RLU-fpga/FPGA_OPTI_DLL_SYNC/Elektronika/Moduliniu ploksciu priekis.png

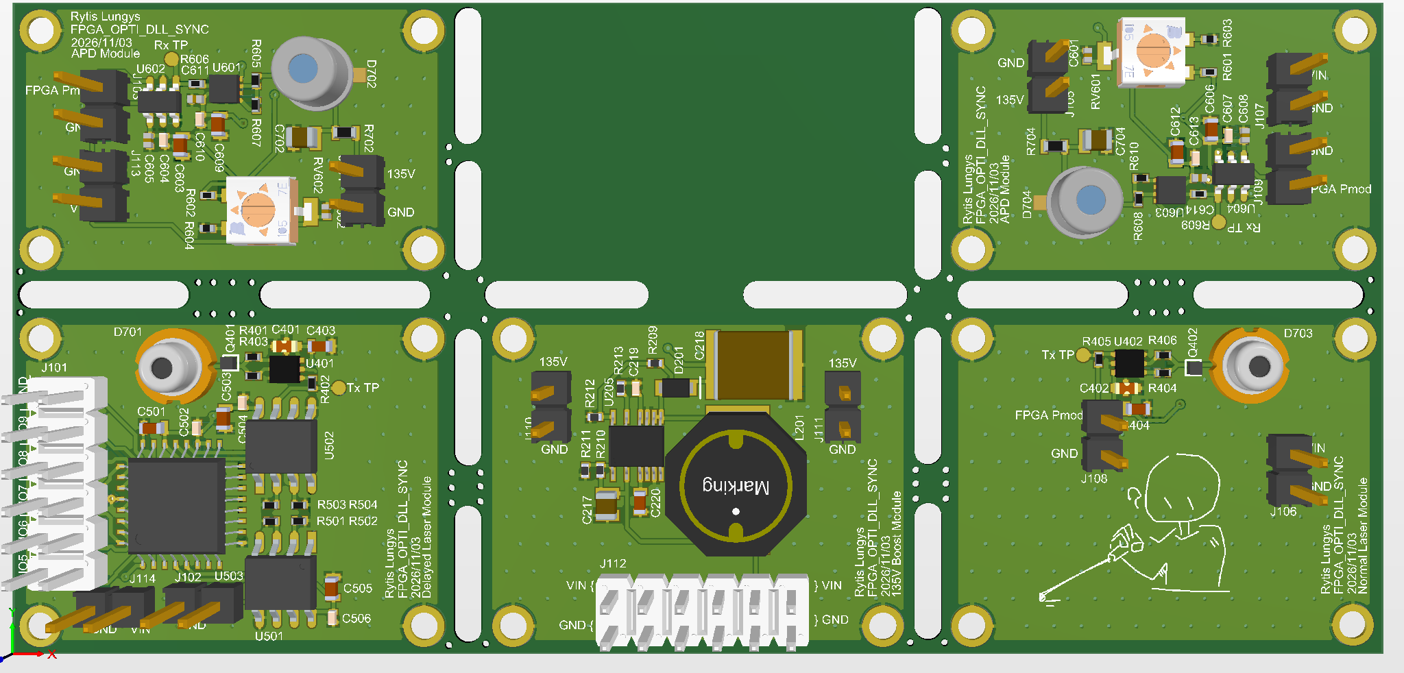
Elektronika/Moduliniu ploksciu priekis.png
