RLU-fpga/FPGA_OPTI_DLL_SYNC/Elektronika/Moduliniu plokscius galas.png

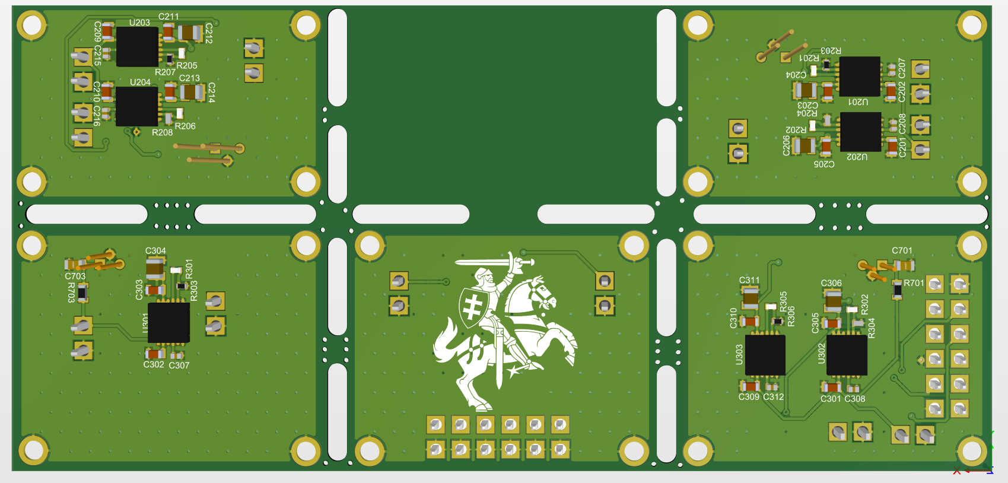
Elektronika/Moduliniu plokscius galas.png
