RLU-fpga/FPGA_OPTI_DLL_SYNC/Mechanika/Kinematinis_Veidriodzio_Laikiklis.png

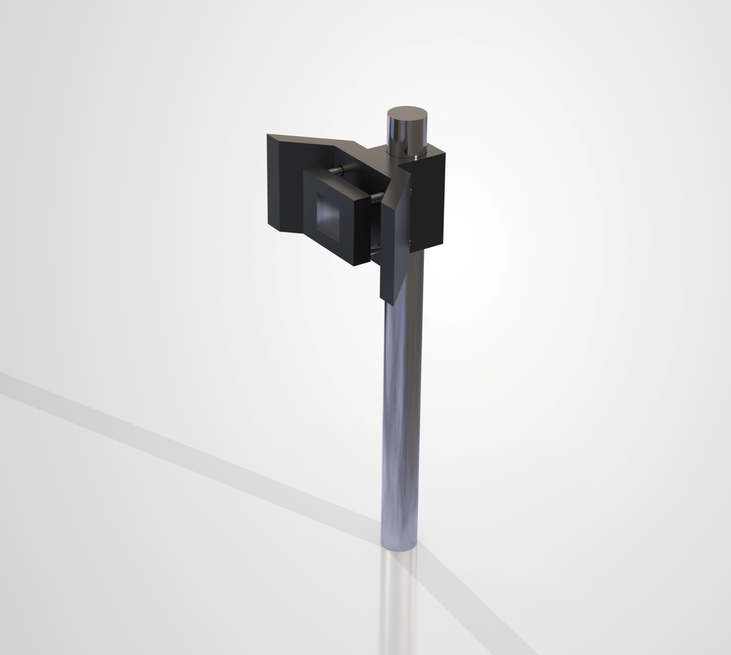
Mechanika/Kinematinis_Veidriodzio_Laikiklis.png
