RLU-fpga/FPGA_OPTI_DLL_SYNC/Vizija.png

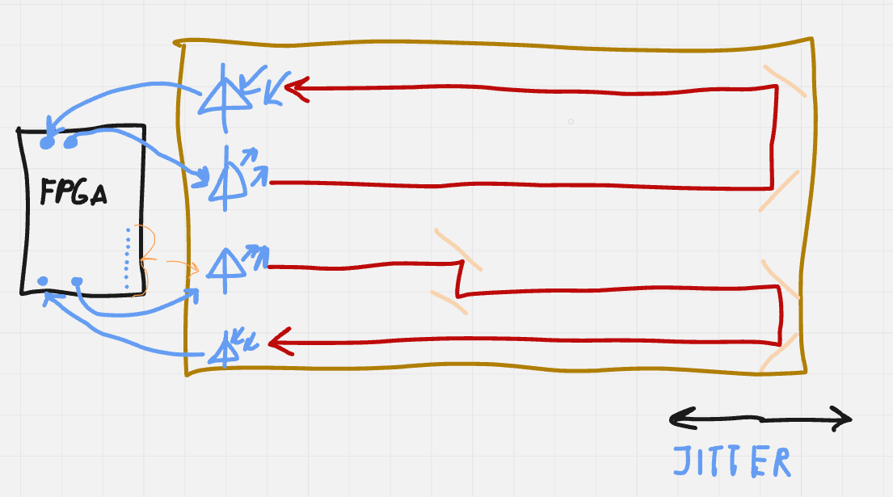
Vizija.png
