RLU-fpga/FPGA_OPTI_DLL_SYNC/BOM.xlsx

Nr. | Komponento kodas | Komponento pavadinimas | Kiekis | Vnt. Kaina | Visu komp. kaina | Designator | Link
1 | CGA3E1X7R1E105K080AC | 1uF | 24 | 0.15 | 3.6 | C201, C202, C203, C205, C209, C210, C211, C213, C220, C301, C302, C303, C305, C309, C310, C401, C403, C405, C503, C504, C603, C606, C609, C612 | https://www.mouser.lt/en/ProductDetail/TDK/CGA3E1X7R1E105K080AC?qs=NRhsANhppD9VxGl2AsmRpw%3D%3D
2 | GRJ21BR61E106KE01K | 10uF | 8 | 0.24 | 1.92 | C204, C206, C212, C214, C217, C304, C306, C311 | https://www.mouser.lt/en/ProductDetail/Murata-Electronics/GRJ21BR61E106KE01K?qs=5aG0NVq1C4w0N7mxlKMI2A%3D%3D
3 | C0402C103J5RACTU | 10nF | 13 | 0.12 | 1.56 | C207, C208, C215, C216, C307, C308, C312, C601, C602, C605, C608, C611, C614 | https://www.mouser.lt/en/ProductDetail/KEMET/C0402C103J5RACTU?qs=DBJr%252BvBUjU4XbiW96tiGZw%3D%3D
4 | CGA9N3X7R2E105M230KA | 1uF | 1 | 1.14 | 1.14 | C218 | https://www.mouser.lt/en/ProductDetail/TDK/CGA9N3X7R2E105M230KA?qs=xLDY6iXSiQZ8rhqg1Ec9Fg%3D%3D
5 | C1005X7R1E104K050BB | 100nF | 8 | 0.17 | 1.36 | C219, C402, C404, C406, C604, C607, C610, C613 | https://www.mouser.lt/en/ProductDetail/TDK/C1005X7R1E104K050BB?qs=dfay7wIA1uG4zQgf5CEiiA%3D%3D
6 | NFM18PC104R1C3D | 100n FT | 2 | 0.21 | 0.42 | C501, C502 | https://www.mouser.lt/en/ProductDetail/Murata-Electronics/NFM18PC104R1C3D?qs=G44QFJllJuCN26lF8UAu9Q%3D%3D
7 | C0603C680J5RACTU | 68pF | 2 | 0.41 | 0.82 | C701, C703 | https://www.mouser.lt/en/ProductDetail/KEMET/C0603C680J5RACTU?qs=gt1LBUVyoHkeg7uPJfU%2Fxw%3D%3D
8 | GCM21AR72E102KWB1J | 1nF | 2 | 0.51 | 1.02 | C702, C704 | https://www.mouser.lt/en/ProductDetail/Murata-Electronics/GCM21AR72E102KWB1J?qs=6avfeC6zeS7nEc4eaMrKgA%3D%3D
9 | RB558VAM150TR | SDiode | 1 | 0.34 | 0.34 | D201 | https://www.mouser.lt/en/ProductDetail/ROHM-Semiconductor/RB558VAM150TR?qs=4v%252BiZTmLVHHlYdkq3pl7bg%3D%3D
10 | PLT5 450GB | 450nm 100mW lazeris | 2 | 26.45 | 52.9 | D701, D703 | https://www.mouser.lt/en/ProductDetail/ams-OSRAM/PLT5-450GB?qs=rQFj71Wb1eV9IX8cpcqYXg%3D%3D
11 | MTAPD-06-007 | Avalanchinis photo diodas | 2 | 43.72 | 87.44 | D702, D704 | https://www.mouser.lt/en/ProductDetail/Marktech-Optoelectronics/MTAPD-06-007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
12 | TSW-106-09-F-D | Spikelinis conectorius | 2 | 0.97 | 1.94 | J101, J103 | https://www.mouser.lt/en/ProductDetail/Samtec/TSW-106-09-F-D?qs=Cqqh%252BS766wkaRvkfCPh4JQ%3D%3D
13 | TSW-102-16-F-S-RA | Spikelinis conectorius | 12 | 0.24 | 2.88 | J102, J104, J105, J106, J107, J108, J109, J110, J111, J112, J113, J114 | https://www.mouser.lt/en/ProductDetail/Samtec/TSW-102-16-F-S-RA?qs=rU5fayqh%252BE030xBuy%2F1xJg%3D%3D
14 | 744066101 | 100uH | 1 | 1.78 | 1.78 | L201 | https://www.mouser.lt/en/ProductDetail/Wurth-Elektronik/744066101?qs=PGXP4M47uW5S%252BY2N7KhrTQ%3D%3D
15 | EPC2036 | GaN FET | 2 | 1.81 | 3.62 | Q501, Q502 | https://www.mouser.lt/en/ProductDetail/EPC/EPC2036?qs=u4fy%2FsgLU9PCoc5QZ%2FhbEg%3D%3D
16 | CR0402-FX-4752GLF | 47K5 | 4 | 0.09 | 0.36 | R201, R205, R301, R305 | https://www.mouser.lt/en/ProductDetail/Bourns/CR0402-FX-4752GLF?qs=ePR1ZvdkOKLsJKyS4c0SOQ%3D%3D
17 | CR0402-FX-2322GLF | 23K2 | 3 | 0.09 | 0.27 | R202, R206, R302 | https://www.mouser.lt/en/ProductDetail/Bourns/CR0402-FX-2322GLF?qs=JflQ4L8so%2FsQg%252B6Y1yp1SA%3D%3D
18 | CRCW040215K0FKED | 15k | 4 | 0.22 | 0.88 | R203, R207, R303, R306 | https://www.mouser.lt/en/ProductDetail/Vishay/CRCW040215K0FKED?qs=QPqDnsKvzKcgNzJF1YM3gA%3D%3D
19 | CRCW040213K3FKED | 13K3 | 3 | 0.13 | 0.39 | R204, R208, R304 | https://www.mouser.lt/en/ProductDetail/Vishay/CRCW040213K3FKED?qs=8wskyPz2qw2Dyv3qbAQfDw%3D%3D
20 | RC0402FR-7D1ML | 1M | 2 | 0.09 | 0.18 | R209, R210 | https://www.mouser.lt/en/ProductDetail/YAGEO/RC0402FR-7D1ML?qs=F5EMLAvA7IBbmOaJlvZVMQ%3D%3D
21 | RC0402FR-07287KL | 287k | 1 | 0.09 | 0.09 | R211 | https://www.mouser.lt/en/ProductDetail/YAGEO/RC0402FR-07287KL?qs=UOUeRUa%252B8WmeTeP982UyHg%3D%3D
22 | RC0402FR-0712K1L | 12k1 | 1 | 0.09 | 0.09 | R212 | https://www.mouser.lt/en/ProductDetail/YAGEO/RC0402FR-0712K1L?qs=sxZXDnvRBEjWHOPbh48R0Q%3D%3D
23 | RE0402BRE07154KL | 154k | 1 | 0.19 | 0.19 | R213 | https://www.mouser.lt/en/ProductDetail/YAGEO/RE0402BRE07154KL?qs=TyBUSTk9pD9kpfVWq%252BbFjA%3D%3D
24 | ERA-2AED201X | 200R | 6 | 0.09 | 0.54 | R401, R402, R403, R404, R607, R610 | https://www.mouser.lt/en/ProductDetail/Panasonic-Industry/ERA-2AED201X?qs=nho8PGNfA6pknZRuzWVIwQ%3D%3D
25 | CRT0402-FZ-2R00GLF | 2R2 | 2 | 0.09 | 0.18 | R501, R505 | https://www.mouser.lt/en/ProductDetail/Bourns/CRT0402-FZ-2R00GLF?qs=v6mhsJQa3reFEgOwp9Hjlg%3D%3D
26 | ERA-2AKD220X | 22R | 2 | 0.09 | 0.18 | R502, R506 | https://www.mouser.lt/en/ProductDetail/Panasonic-Industry/ERA-2AKD220X?qs=nho8PGNfA6rnpt2x0U9KVw%3D%3D
27 | CRCW040247R0FKED | 47R | 2 | 0.14 | 0.28 | R503, R507 | https://www.mouser.lt/en/ProductDetail/Vishay/CRCW040247R0FKED?qs=rzhQWu8UUS1jEbQS506e8Q%3D%3D
28 | CRT0402-FZ-1R00GLF | 1R | 2 | 0.14 | 0.28 | R504, R508 | https://www.mouser.lt/en/ProductDetail/Vishay/CRCW040247R0FKED?qs=rzhQWu8UUS1jEbQS506e8Q%3D%3D
29 | ERA-2VEB1000X | 100R | 4 | 0.25 | 1 | R601, R602, R606, R609 | https://www.mouser.lt/en/ProductDetail/Panasonic-Industry/ERA-2VEB1000X?qs=OlC7AqGiEDnVwVem9FjbZg%3D%3D
30 | ERJ-U02F3301X | 3K3 | 2 | 0.11 | 0.22 | R603, R604 | https://www.mouser.lt/en/ProductDetail/Panasonic-Industry/ERJ-U02F3301X?qs=bKFmlxG1yYAqEK%252Bo9PdYEQ%3D%3D
31 | CRT0402-DZ-10R0GLF | 10R | 2 | 0.11 | 0.22 | R605, R608 | https://www.mouser.lt/en/ProductDetail/Bourns/CRT0402-DZ-10R0GLF?qs=1mbolxNpo8ePU9UbXC2foA%3D%3D
32 | ERA-3AEB102V | 1K | 2 | 0.28 | 0.56 | R701, R703 | https://www.mouser.lt/en/ProductDetail/Panasonic-Industry/ERA-3AEB102V?qs=1VWA5LkbEaoqrqE7i0E0xA%3D%3D
33 | CR0603-FX-1003ELF | 100k | 2 | 0.09 | 0.18 | R702, R704 | https://www.mouser.lt/en/ProductDetail/Bourns/CR0603-FX-1003ELF?qs=K5ddiUFZPT49r0RoKWcKqg%3D%3D
34 | 3314G-1-502E | 5K TRIM | 2 | 1.35 | 2.7 | RV601, RV602 | https://www.mouser.lt/en/ProductDetail/Bourns/3314G-1-502E?qs=VLB%252BJtKnxCKiclk60ejpgA%3D%3D
35 | LP38798SD-ADJ/NOPB | LDO | 7 | 4.46 | 31.22 | U201, U202, U203, U204, U301, U302, U303 | https://www.mouser.lt/en/ProductDetail/Texas-Instruments/LP38798SD-ADJ-NOPB?qs=n38Wlrh4b4YOH8S0VaMj1g%3D%3D
36 | LT8331EMSE#PBF | Boost keitiklis | 1 | 9.08 | 9.08 | U205 | https://www.mouser.lt/en/ProductDetail/Analog-Devices/LT8331EMSEPBF?qs=oahfZPh6IAIKOCqw%2F9bOKA%3D%3D
37 | MC100EPT20DR2G | LVCMOS vertejas | 1 | 6.56 | 6.56 | U401 | https://www.mouser.lt/en/ProductDetail/onsemi/MC100EPT20DR2G?qs=zorda86t5M%252BrhsQdqEkc9w%3D%3D
38 | MC100EPT21DR2G | LVCMOS vertejas | 1 | 6.23 | 6.23 | U402 | https://www.mouser.lt/en/ProductDetail/onsemi/MC100EPT21DR2G?qs=zorda86t5M%2FXPFeU0zEWZg%3D%3D
39 | MC100EP195FAG | Velintojas | 1 | 17.78 | 17.78 | U403 | https://www.mouser.lt/en/ProductDetail/onsemi/MC100EP195FAG?qs=zorda86t5M%2FizCrh52Y4cQ%3D%3D
40 | LMG1025QDEERQ1 | GaN Driver | 2 | 11.4 | 22.8 | U501, U502 | https://www.mouser.lt/en/ProductDetail/Texas-Instruments/LMG1025QDEERQ1?qs=B6kkDfuK7%2FDnZFw0EtktSw%3D%3D
41 | OPA855IDSGT | Op Ampas | 2 | 7.94 | 15.88 | U601, U603 | https://www.mouser.lt/en/ProductDetail/Texas-Instruments/OPA855IDSGT?qs=w%2Fv1CP2dgqr2Ni5Q69cmdQ%3D%3D
42 | TLV3501AIDBVT | Komporatorius | 2 | 4.26 | 8.52 | U602, U604 | https://www.mouser.lt/en/ProductDetail/Texas-Instruments/TLV3501AIDBVT?qs=m96fseALk3Uwvp8U7e8R1g%3D%3D
 |  |  |  | Viso Kaina: | 289.6
