RLU-fpga/FPGA_OPTI_DLL_SYNC/Mechanika/Veidrodzio_laikiklis/Laikiklio_laikiklis.SLDPRT

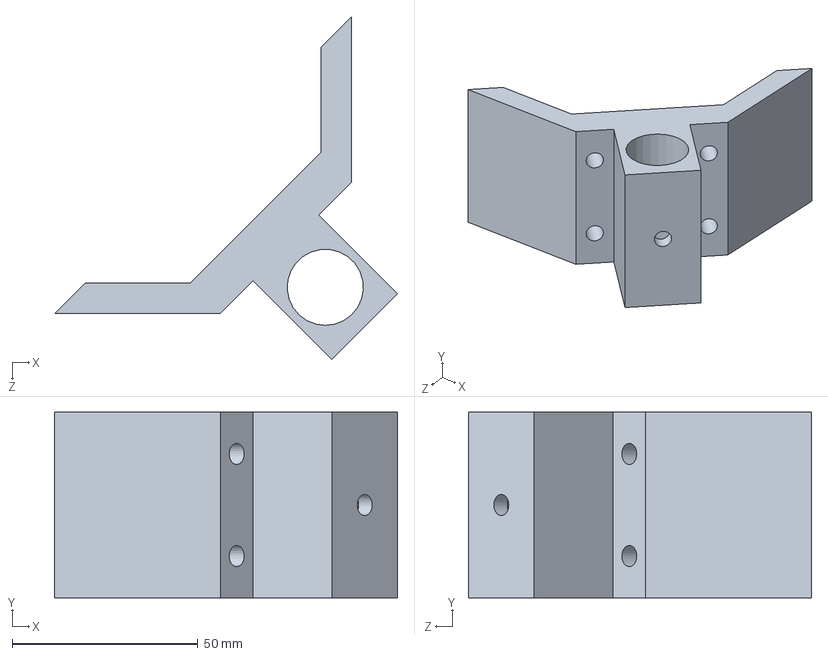
[picture p5: CAD file, 2026-11-05]
Mechanika/Veidrodzio_laikiklis/Laikiklio_laikiklis.SLDPRT
92.4 x 50.0 x 92.4 mm
