RLU-fpga/FPGA_OPTI_DLL_SYNC/Mechanika/Veidrodzio_laikiklis/Strypas_laikiklis.SLDPRT

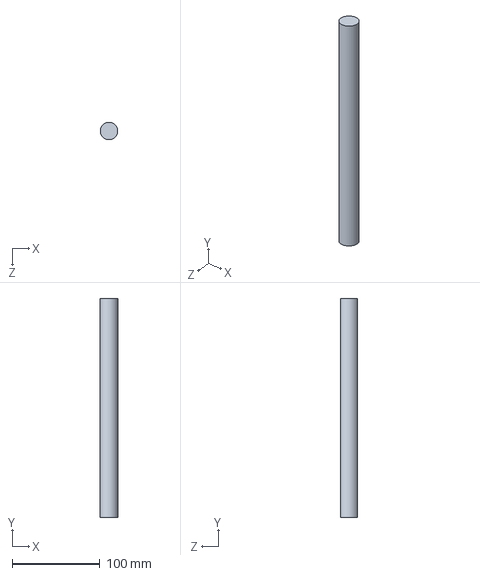
[picture p6: CAD file, 2026-11-05]
Mechanika/Veidrodzio_laikiklis/Strypas_laikiklis.SLDPRT
20.0 x 250.0 x 20.0 mm
