RLU-fpga/FPGA_OPTI_DLL_SYNC/Mechanika/Veidrodzio_laikiklis/Veidrodzio_laikiklis.SLDPRT

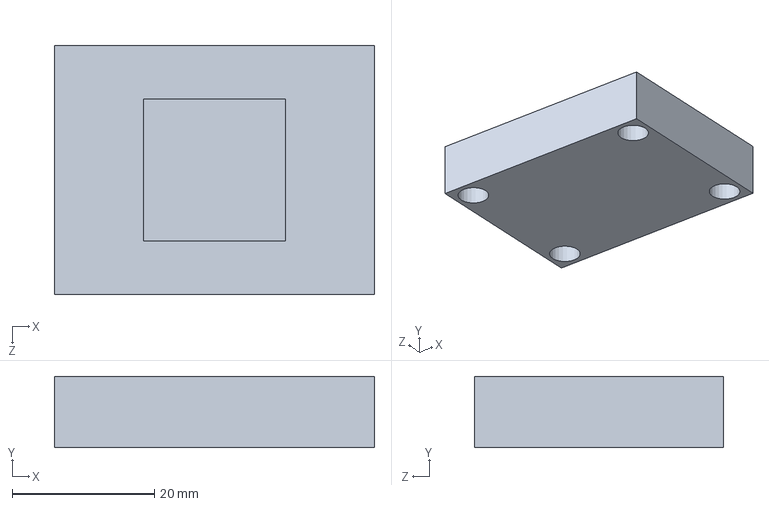
[picture p7: CAD file, 2026-11-05]
Mechanika/Veidrodzio_laikiklis/Veidrodzio_laikiklis.SLDPRT
45.0 x 10.0 x 35.0 mm
