RLU-fpga/FPGA_OPTI_DLL_SYNC/Mechanika/Veidrodzio_laikiklis/Veidrodis_laikiklis.SLDPRT

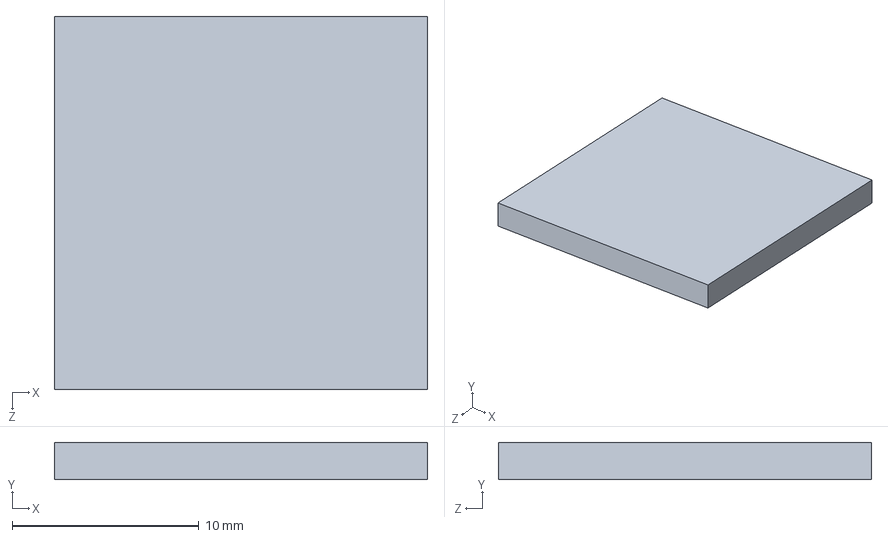
[picture p8: CAD file, 2026-11-05]
Mechanika/Veidrodzio_laikiklis/Veidrodis_laikiklis.SLDPRT
20.0 x 2.00 x 20.0 mm
