RLU-fpga/FPGA_OPTI_DLL_SYNC/Mechanika/Veidrodzio_laikiklis/Kinematinis_Veidriodzio_Laikiklis.SLDASM

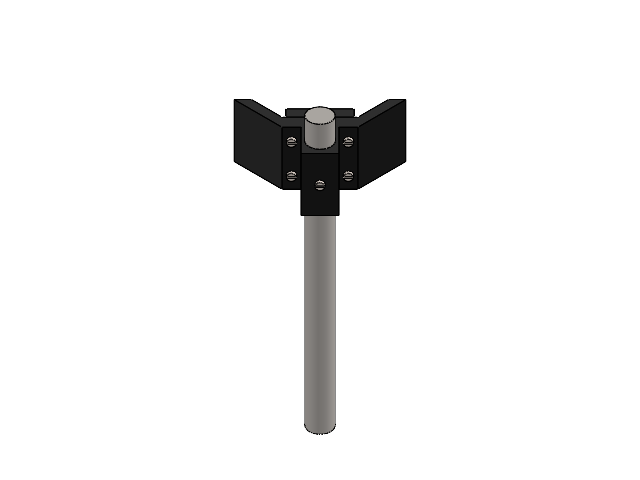
[picture p9: CAD file, 2026-11-05]
Mechanika/Veidrodzio_laikiklis/Kinematinis_Veidriodzio_Laikiklis.SLDASM
Laikiklio_laikiklis
Veidrodzio_laikiklis
Strypas_laikiklis
Veidrodis_laikiklis
slotted cheese head screw_din x 5
