RLU-fpga/FPGA_OPTI_DLL_SYNC/(list of files, cad)

Other CAD files:
Mechanika/Veidrodzio_laikiklis/Kinematinis_Veidriodzio_Laikiklis.SLDDRW
Mechanika/Veidrodzio_laikiklis/Laikiklio_laikiklis.SLDDRW
Mechanika/Veidrodzio_laikiklis/Strypas_laikiklis.SLDDRW
Mechanika/Veidrodzio_laikiklis/Veidrodis_laikiklis.SLDDRW
Mechanika/Veidrodzio_laikiklis/Veidrodzio_laikiklis.SLDDRW
