RLU-fpga/FPGA_OPTI_DLL_SYNC/Elektronika/Schematics.pdf

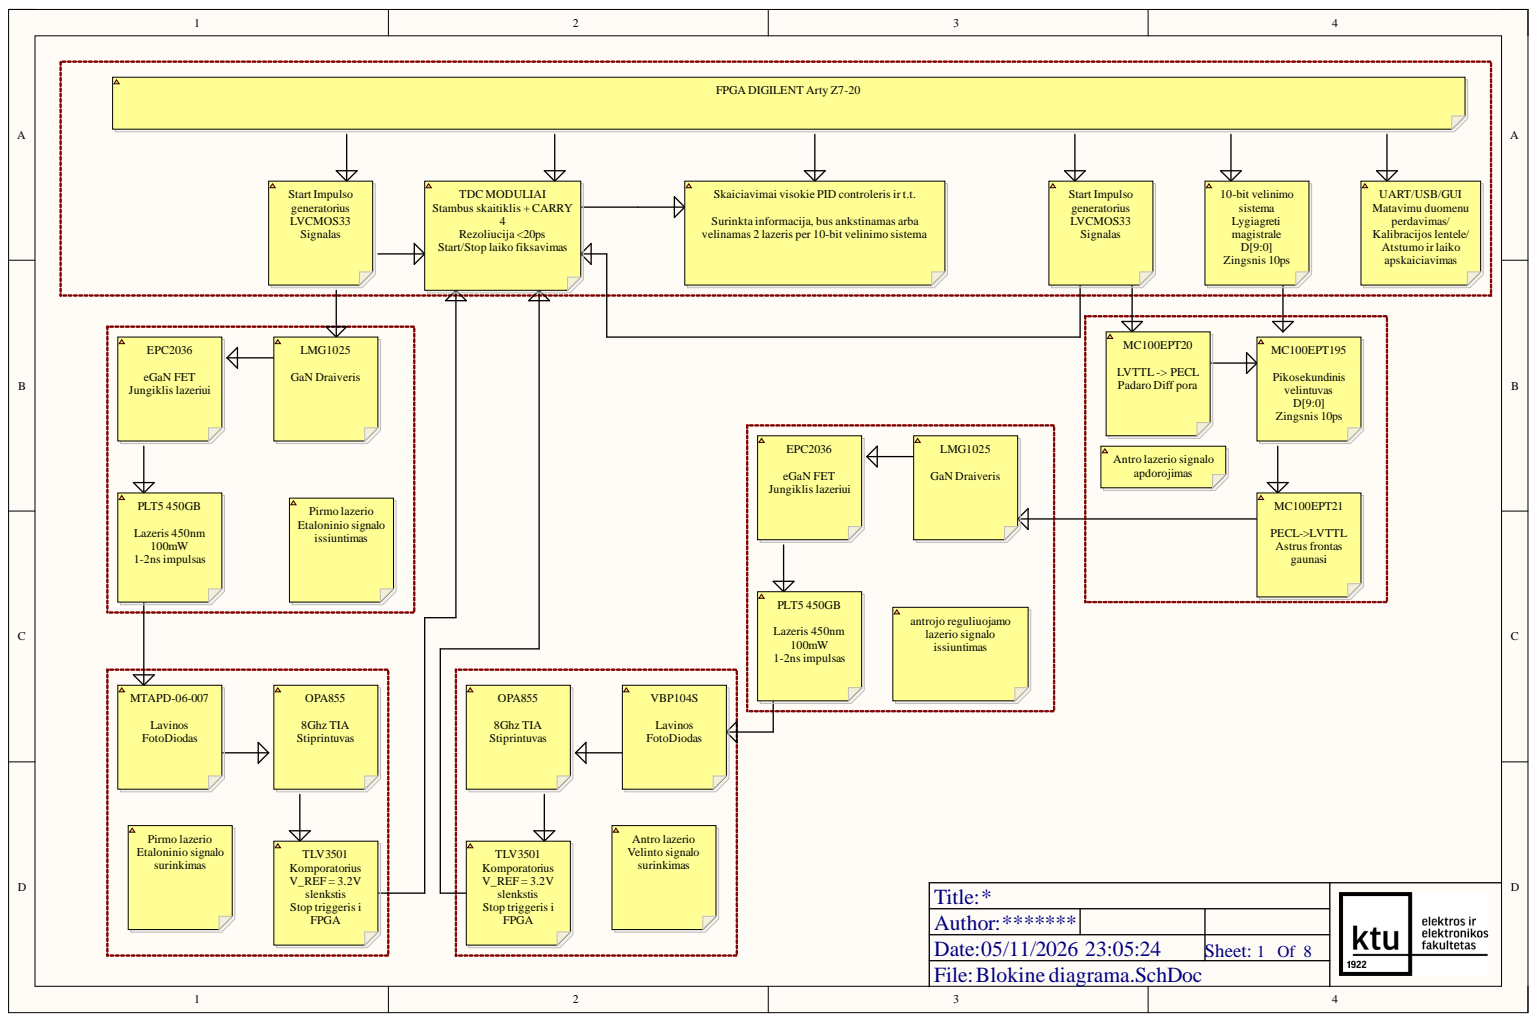
[picture p10: page 1]

Skaiciavimai visokie PID controleris ir t.t.

Surinkta informacija, bus ankstinamas arba
velinamas 2 lazeris per 10-bit velinimo sistema

Rezoliucija <20ps
Start/Stop laiko fiksavimas

Author:*******
Date:05/11/2026 23:05:24 | Sheet: 1 Of 8

File:Blokine diagrama.SchDoc

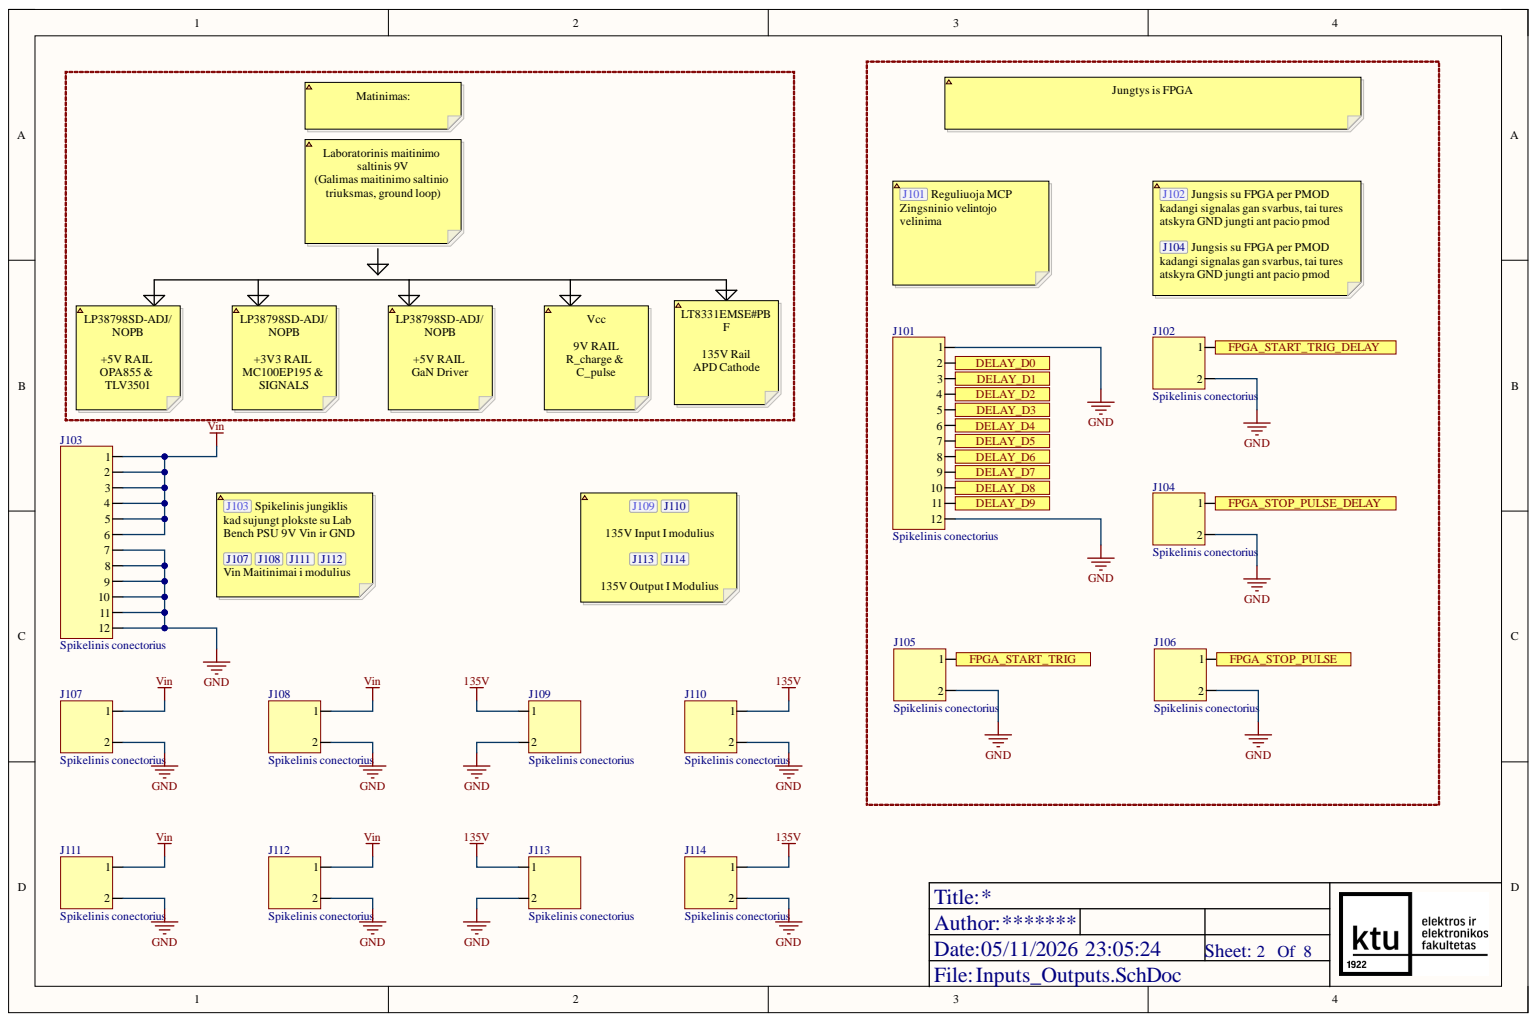
[picture p11: page 2]

J102 Jungsis su FPGA per PMOD
kadangi signalas gan svarbus, tai tures
atskyra GND jungti ant pacio pmod

J104 Jungsis su FPGA per PMOD

J103 Spikelinis jungiklis
kad sujungt plokste su Lab
Bench PSU 9V Vin ir GND

Author:*******
Date:05/11/2026 23:05:24 | Sheet: 2 Of 8

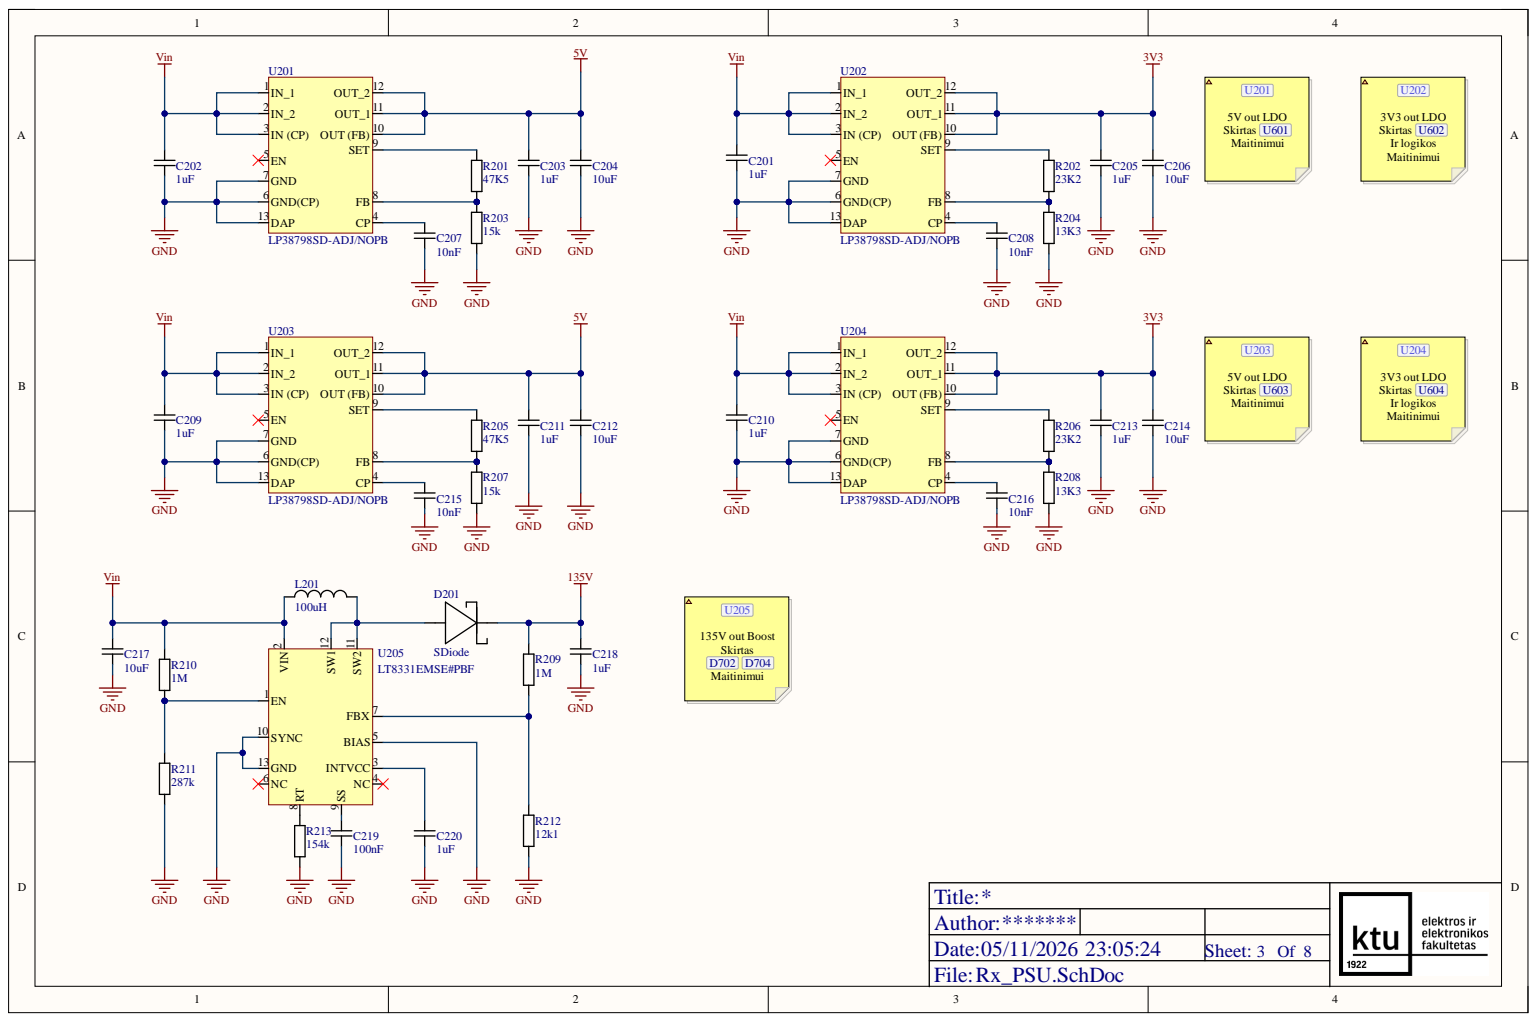
[picture p12: page 3]

1 3 | | 3

Auth o r : * * * * * * *
Date : 0 5/1 1 / 2 0 2 6 2 3:0 5 : 2 4 | Sheet: 3 O f 8

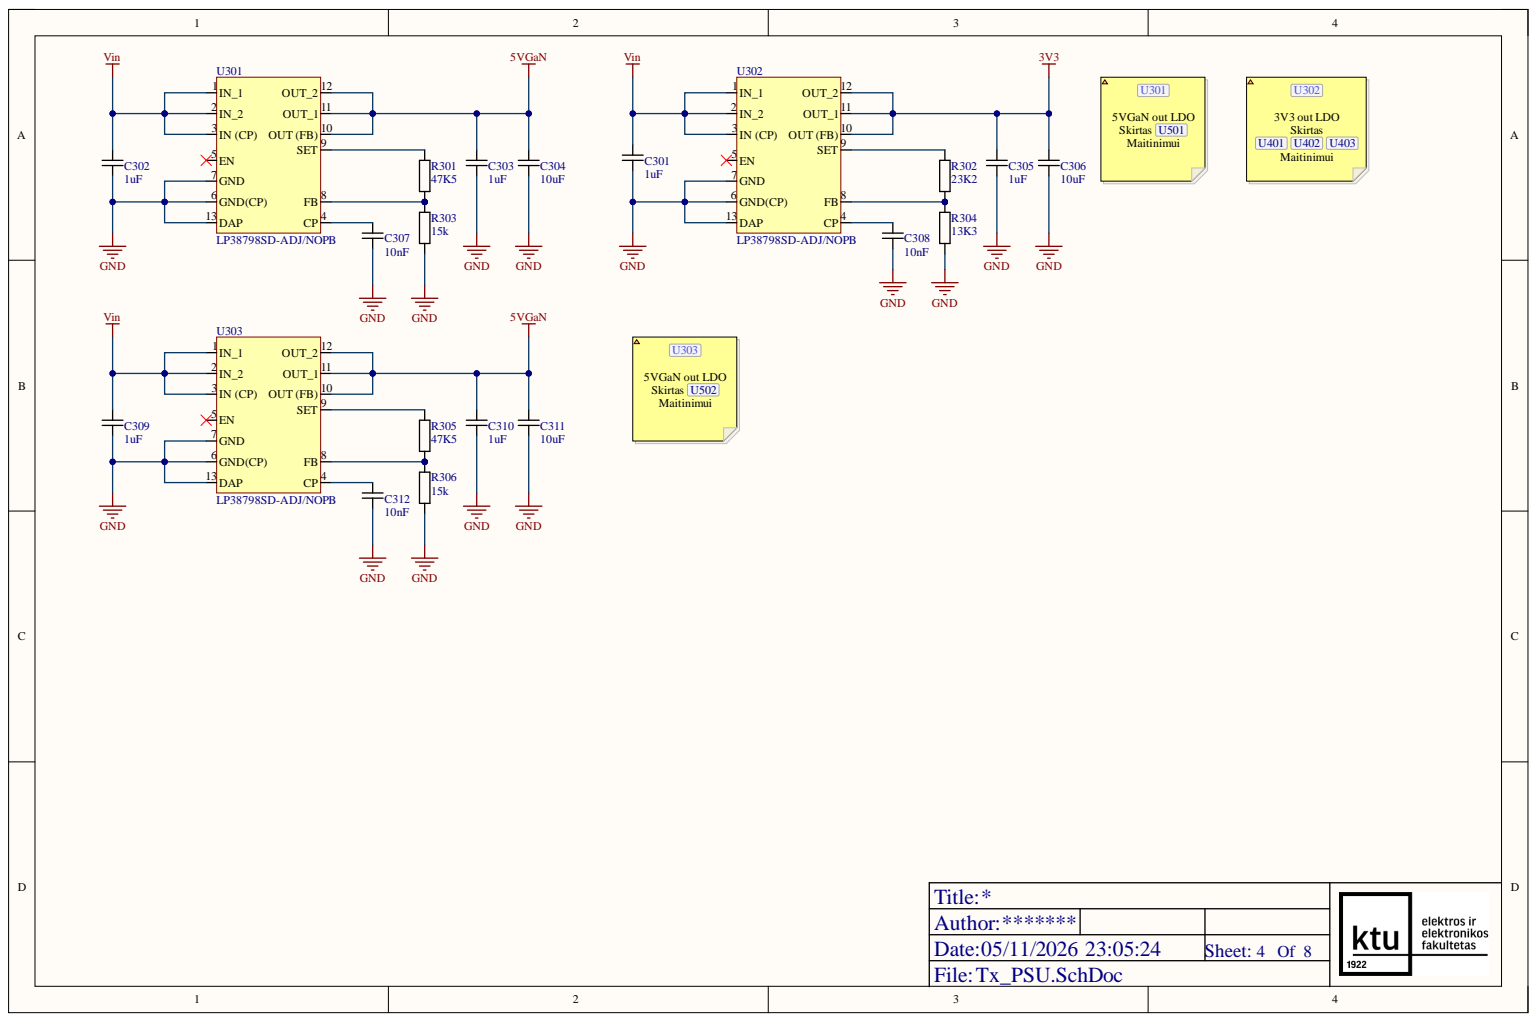
[picture p13: page 4]

2 | | 1 1
3 | | 1 0

1 3

Auth o r : * * * * * * *
Date : 0 5/1 1 / 2 0 2 6 2 3:0 5 : 2 4 | Sheet: 4 O f 8

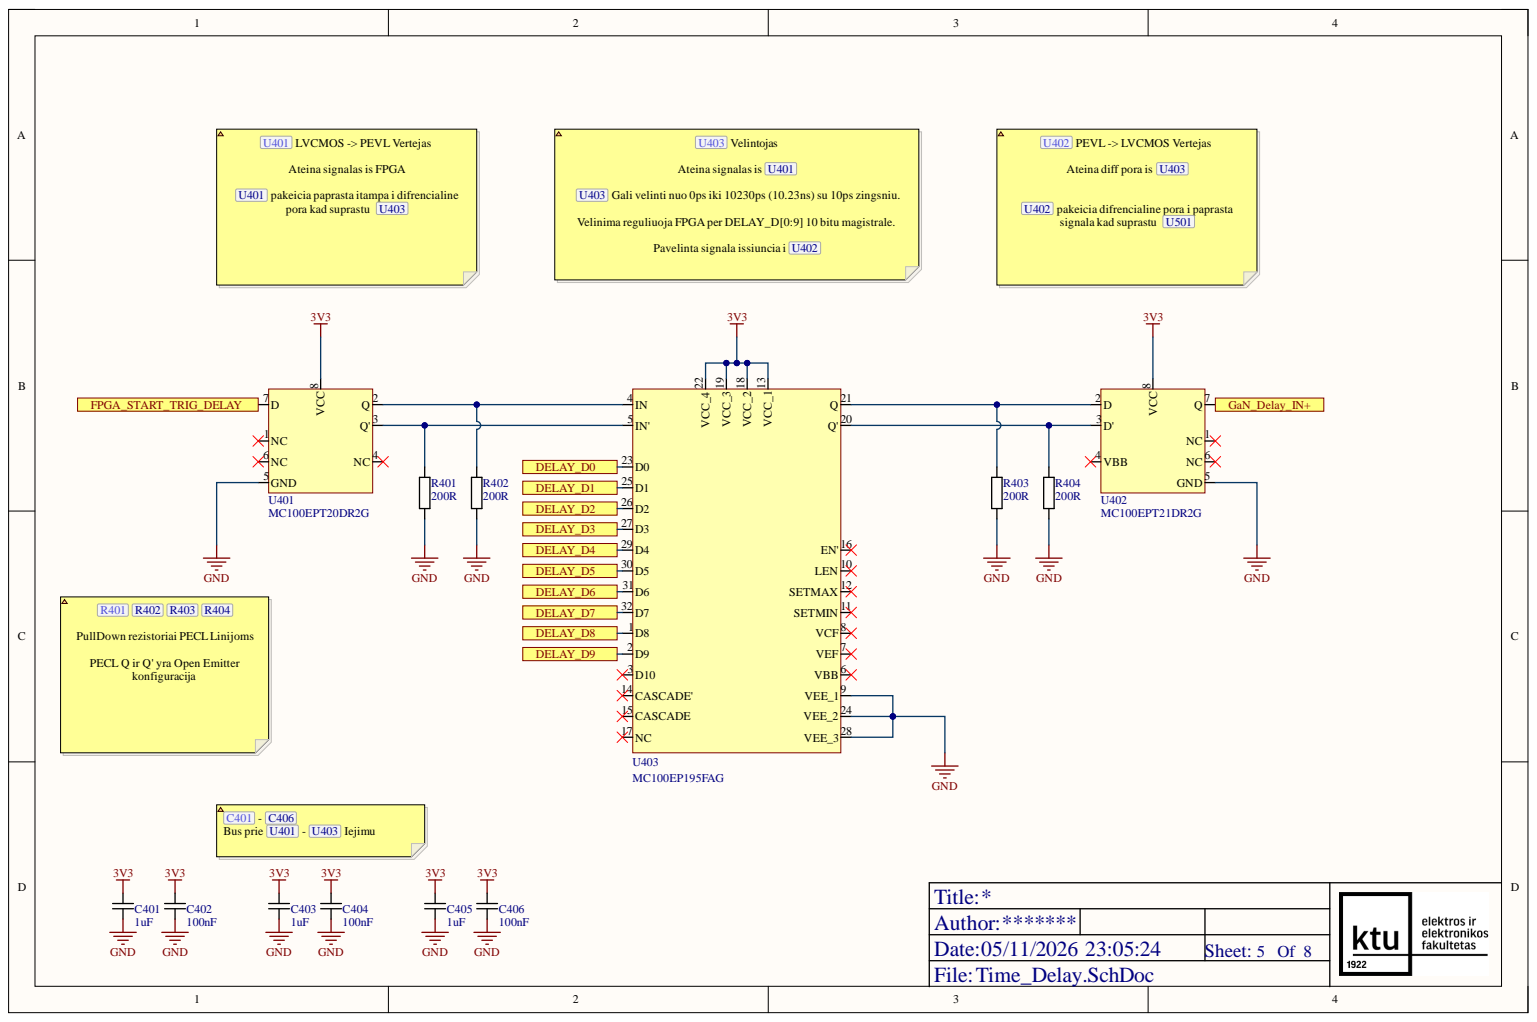
[picture p14: page 5]

Ateina signalas is FPGA

Ateina diff pora is U403

U401 pakeicia paprasta itampa i difrencialine

U403 Gali velinti nuo 0ps iki 10230ps (10.23ns) su 10ps zingsniu.

U402 pakeicia difrencialine pora i paprasta

Velinima reguliuoja FPGA per DELAY_D[0:9] 10 bitu magistrale.

D0 23 D1 25 D2 26 D3 27 D4 29 D5 30 D6 31 D7 32 D8 1 D9 2 D10 3 CASCADE' 14 CASCADE 15 NC 17 | | | VBB 4

PullDown rezistoriai PECL Linijoms

PECL Q ir Q' yra Open Emitter

Author:*******
Date:05/11/2026 23:05:24 | Sheet: 5 Of 8

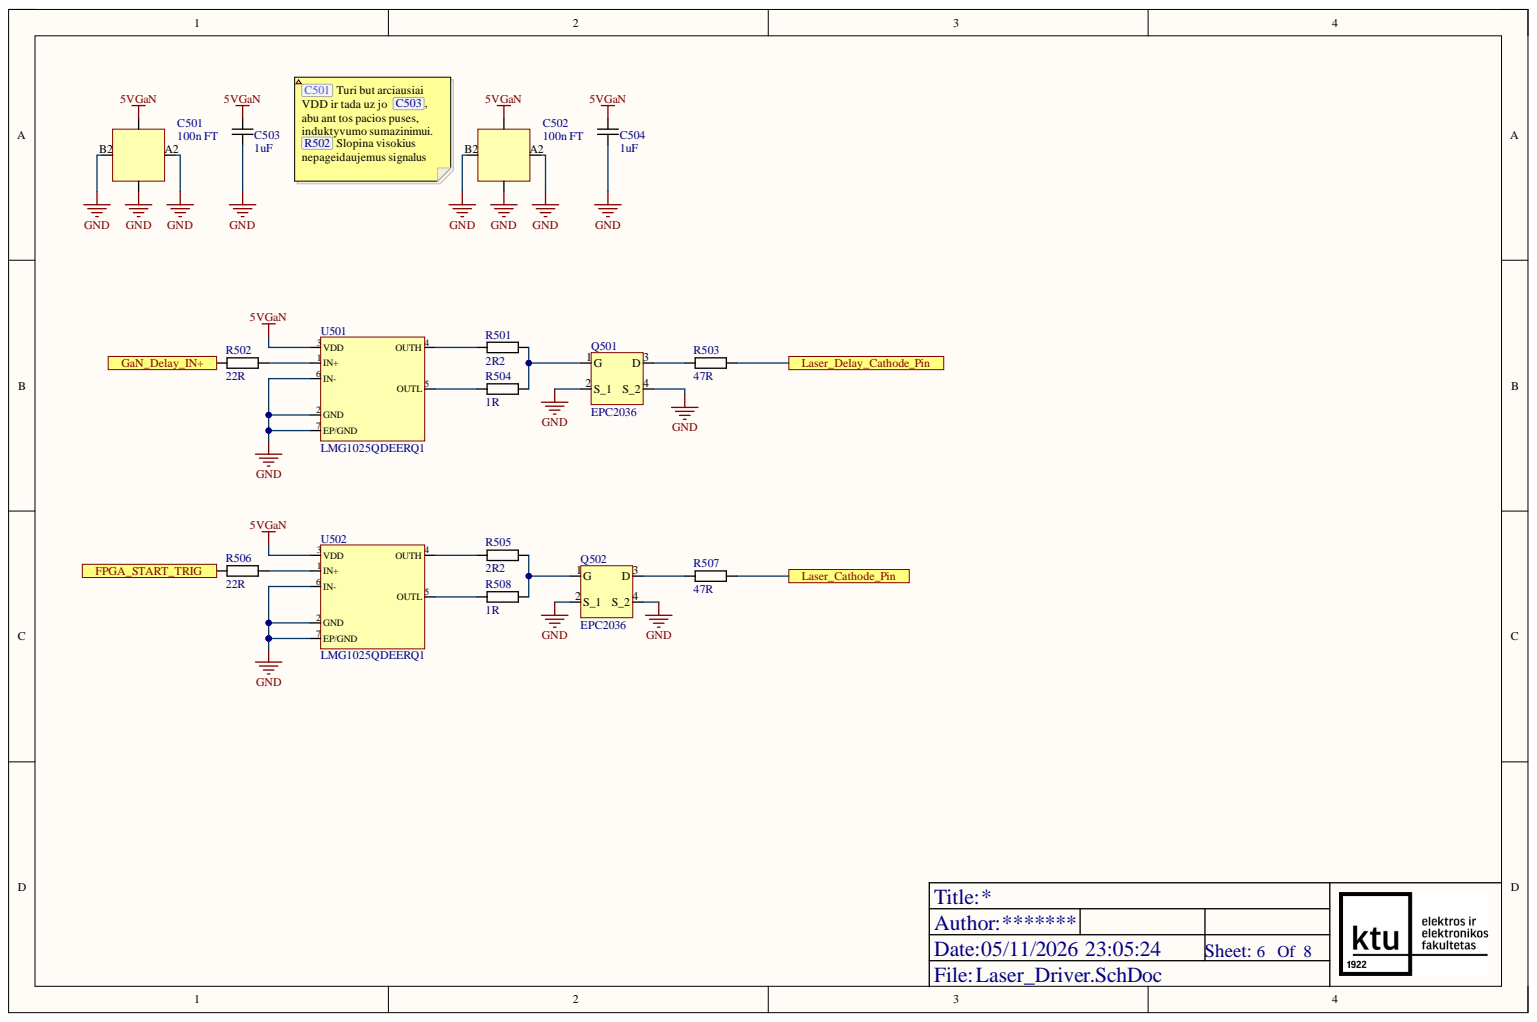
[picture p15: page 6]

C501 Turi but arciausiai
VDD ir tada uz jo C503 ,
abu ant tos pacios puses,
induktyvumo sumazinimui.
R502 Slopina visokius
nepageidaujemus signalus

Author:*******
Date:05/11/2026 23:05:24 | Sheet: 6 Of 8

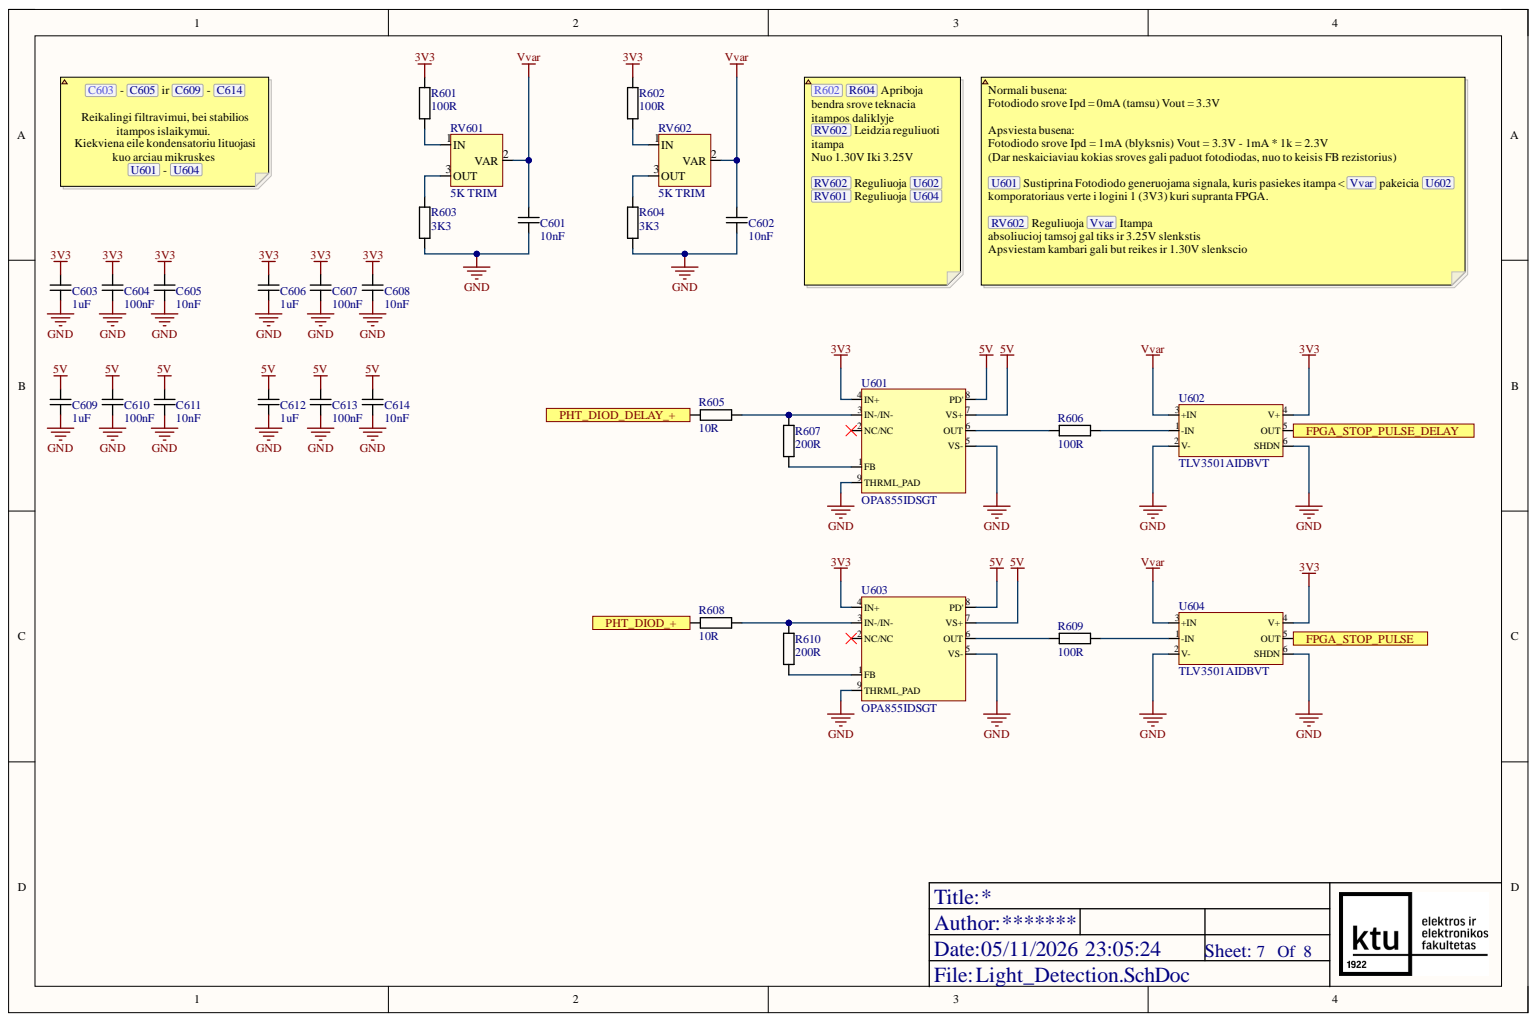
[picture p16: page 7]

Normali busena:
Fotodiodo srove Ipd = 0mA (tamsu) Vout = 3.3V

Apsviesta busena:
Fotodiodo srove Ipd = 1mA (blyksnis) Vout = 3.3V - 1mA * 1k = 2.3V
(Dar neskaiciaviau kokias sroves gali paduot fotodiodas, nuo to keisis FB rezistorius)

Kiekviena eile kondensatoriu lituojasi

U601 Sustiprina Fotodiodo generuojama signala, kuris pasiekes itampa < Vvar pakeicia U602
komporatoriaus verte i logini 1 (3V3) kurisupranta FPGA.

RV602 Reguliuoja Vvar Itampa
absoliucioj tamsoj gal tiks ir 3.25V slenkstis
Apsviestam kambari gali but reikes ir 1.30V slenkscio

Author:*******
Date:05/11/2026 23:05:24 | Sheet: 7 Of 8

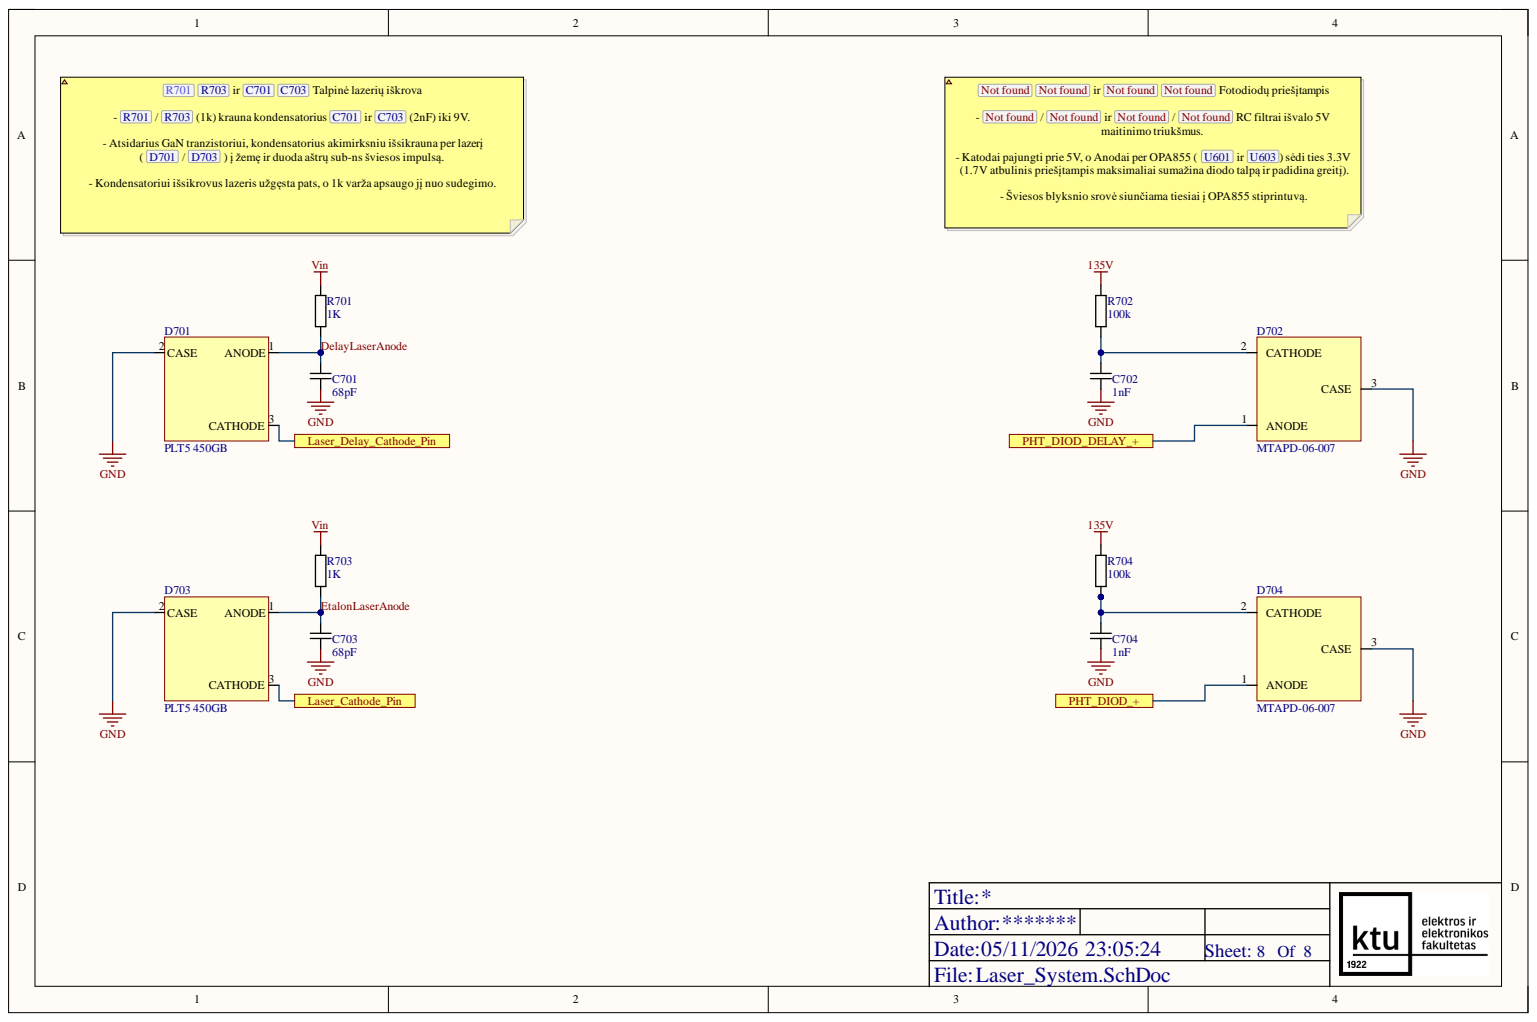
[picture p17: page 8]

Auth o r : * * * * * * *
Date : 0 5/1 1 / 2 0 2 6 2 3:0 5 : 2 4 | Sheet: 8 O f 8

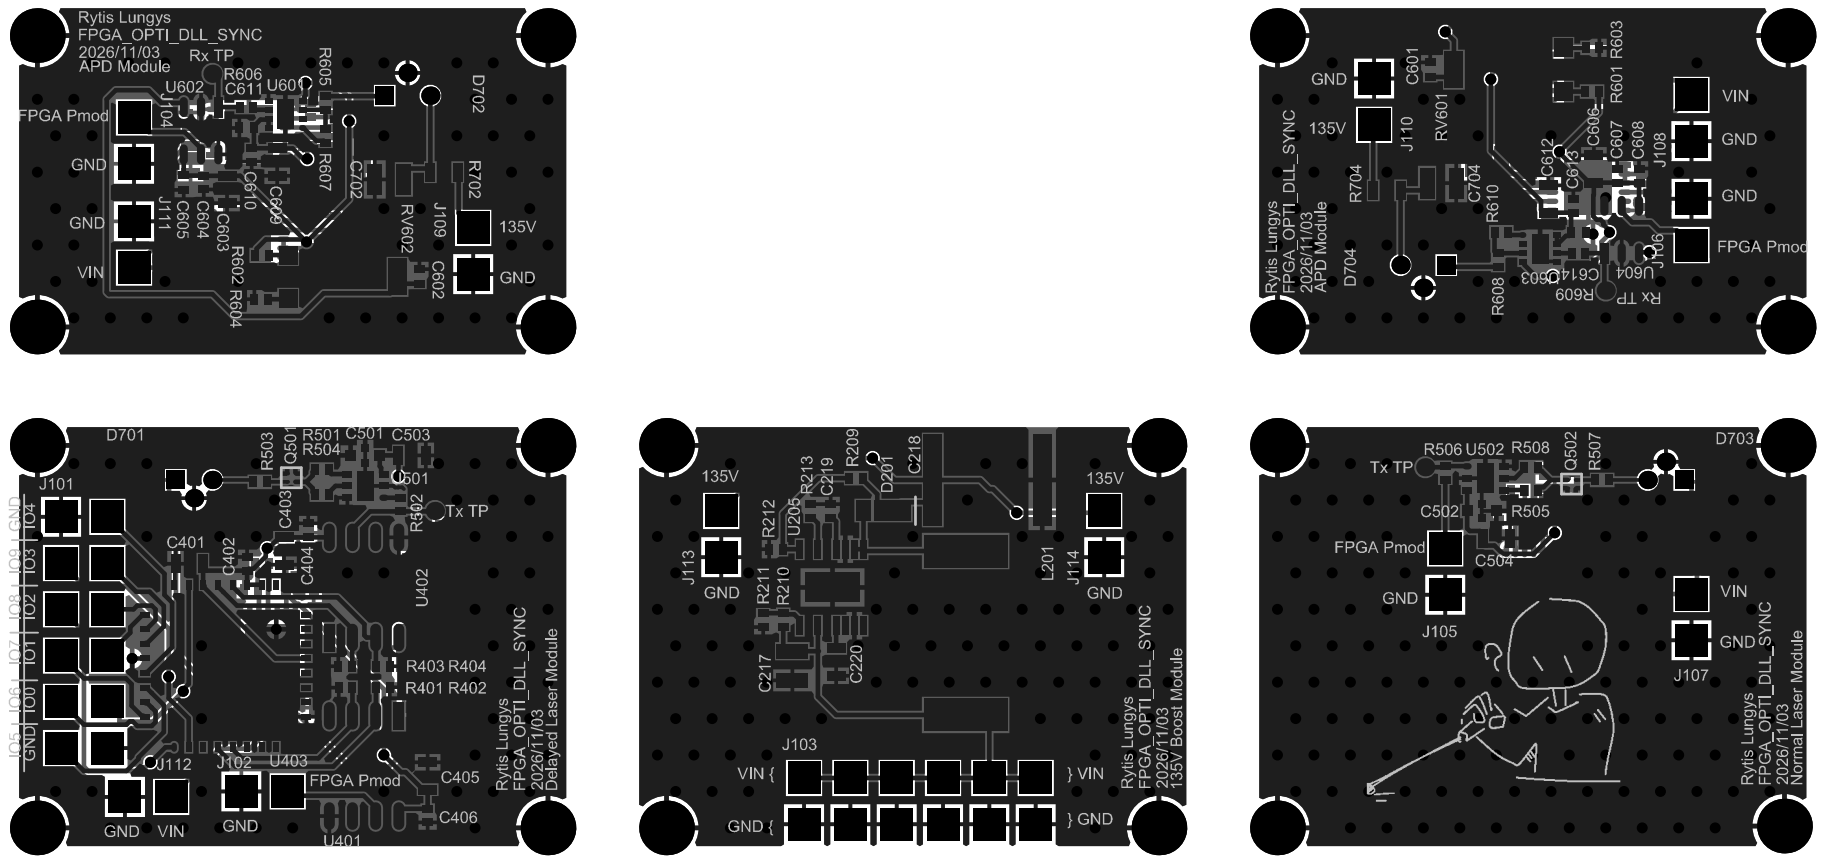
[picture p18: page 9]
