RLU-fpga/FPGA_OPTI_DLL_SYNC/(list of files, drawings)

Other design files:
Elektronika/odll_sync_pcb_V1/Blokine diagrama.SchDoc
Elektronika/odll_sync_pcb_V1/Inputs_Outputs.SchDoc
Elektronika/odll_sync_pcb_V1/Laser_Driver.SchDoc
Elektronika/odll_sync_pcb_V1/Laser_System.SchDoc
Elektronika/odll_sync_pcb_V1/Light_Detection.SchDoc
Elektronika/odll_sync_pcb_V1/PcbLib1.PcbLib
Elektronika/odll_sync_pcb_V1/Prototype_REV1.PcbDoc
Elektronika/odll_sync_pcb_V1/Rx_PSU.SchDoc
Elektronika/odll_sync_pcb_V1/Schlib1.SchLib
Elektronika/odll_sync_pcb_V1/StarWars.PrjPcb
Elektronika/odll_sync_pcb_V1/Time_Delay.SchDoc
Elektronika/odll_sync_pcb_V1/Tx_PSU.SchDoc
