RLU-fpga/FPGA_OPTI_DLL_SYNC/(commit log)

2026-11-03 Issiusta plokste i pagaminima
    [Blokine diagrama.SchDoc, Inputs_Outputs.SchDoc, Laser_Driver.SchDoc, Laser_System.SchDoc, Light_Detection.SchDoc, PcbLib1.PcbLib, Power_Supply.SchDoc, Prototype_REV1.PcbDoc]
2026-11-05 Pradeta mechanikos/remo dalis
    [Blokine diagrama.SchDoc, Inputs_Outputs.SchDoc, Kinematinis_Veidriodzio_Laikiklis.SLDASM, Kinematinis_Veidriodzio_Laikiklis.SLDDRW, Laikiklio_laikiklis.SLDDRW, Laikiklio_laikiklis.SLDPRT, Laser_Driver.SchDoc, Laser_System.SchDoc]
